goney3/openscad-flanging-dies/(commit log)

2026-05-04 Add files via upload
    initial upload
    [Lightening_Holes_Flanging_Dies.scad]
2026-05-04 Revise README with detailed usage and customization info
    Expanded README to include detailed instructions and customization options for parametric flanging dies, including recommended print settings and important notes on metal thickness.
2026-05-06 Update Lightening_Holes_Flanging_Dies.scad
    Added Disclaimer of Liability and Warranty
    [Lightening_Holes_Flanging_Dies.scad]
2026-05-06 Update Lightening_Holes_Flanging_Dies.scad
    Updated name in Disclaimer
    [Lightening_Holes_Flanging_Dies.scad]
